wyolum/Celeste/README.md

Celeste
=======

decorative celestial clock

License
-------
[CERN Open Hardware Licence v1.2 ]

[CERN Open Hardware Licence v1.2 ]:http://www.ohwr.org/attachments/2388/cern_ohl_v_1_2.txt
