wyolum/Celeste/fabricate/3D_printed/gears4_8_minute_hand.stl

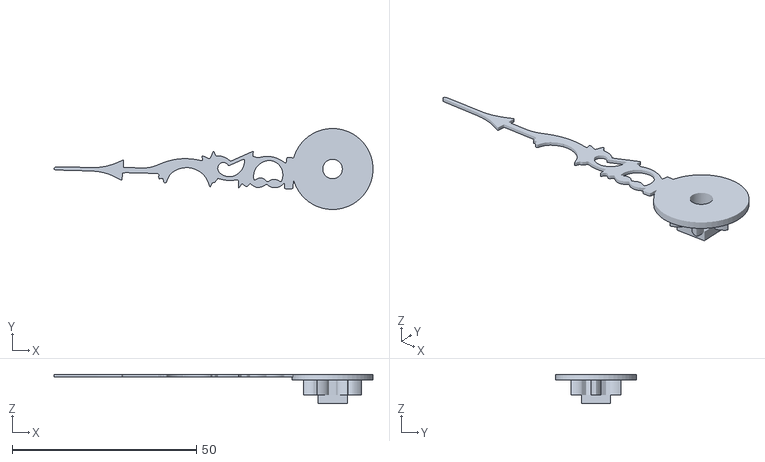
[picture p1: CAD file, 2015-02-06]
fabricate/3D_printed/gears4_8_minute_hand.stl
86.6 x 22.0 x 8.00
