wyolum/Celeste/fabricate/filagreeminute.dxf

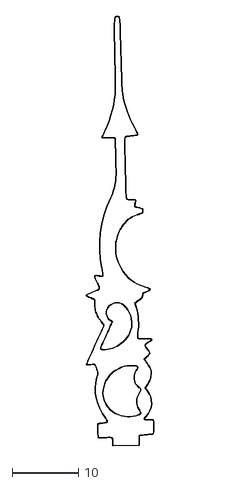
[picture p2: CAD file, 2014-12-28]
fabricate/filagreeminute.dxf
10.2 x 65.0
