wyolum/Celeste/fabricate/3D_printed/gears4_5_hour_hand.stl

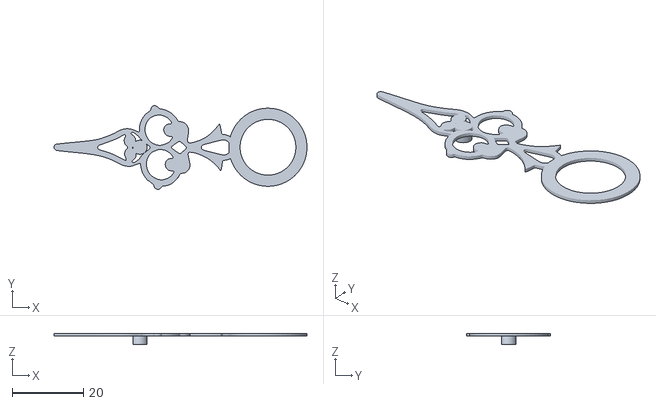
[picture p3: CAD file, 2015-02-06]
fabricate/3D_printed/gears4_5_hour_hand.stl
71.2 x 23.6 x 3.20
