wyolum/Celeste/fabricate/filagreehour.dxf

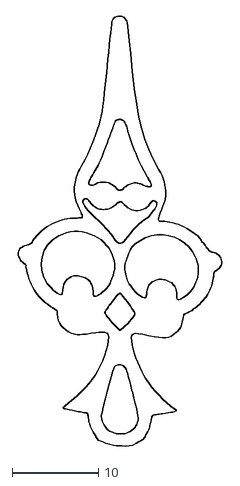
[picture p4: CAD file, 2014-12-28]
fabricate/filagreehour.dxf
23.6 x 49.8
