wyolum/Celeste/fabricate/3D_printed/gears4_7_second_hand.stl

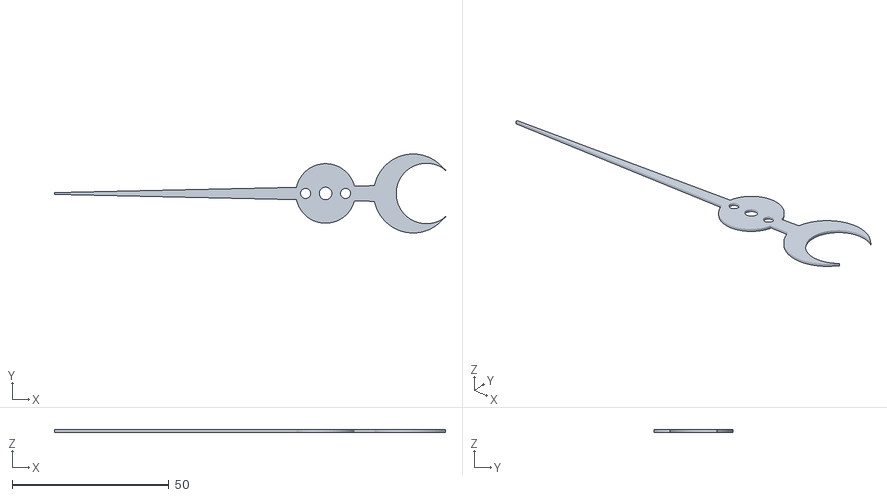
[picture p5: CAD file, 2015-02-06]
fabricate/3D_printed/gears4_7_second_hand.stl
124.6 x 25.2 x 0.8
