wyolum/Celeste/fabricate/minute_hand.stl

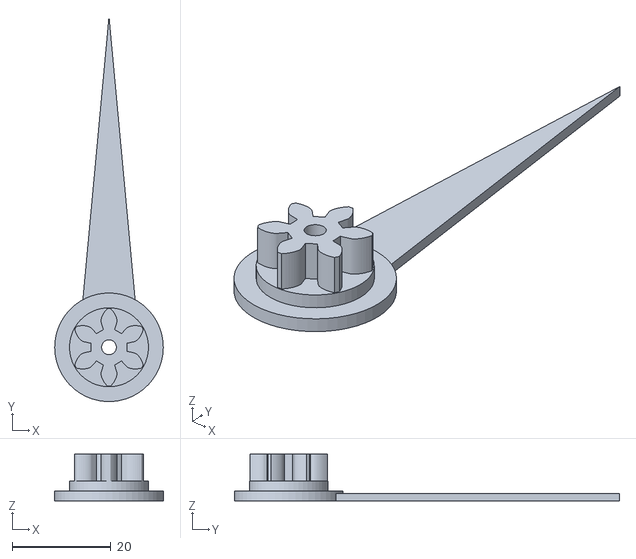
[picture p6: CAD file, 2014-12-27]
fabricate/minute_hand.stl
22.0 x 78.0 x 9.50
