wyolum/Celeste/fabricate/3D_printed/gears4_5_hour_snap.stl

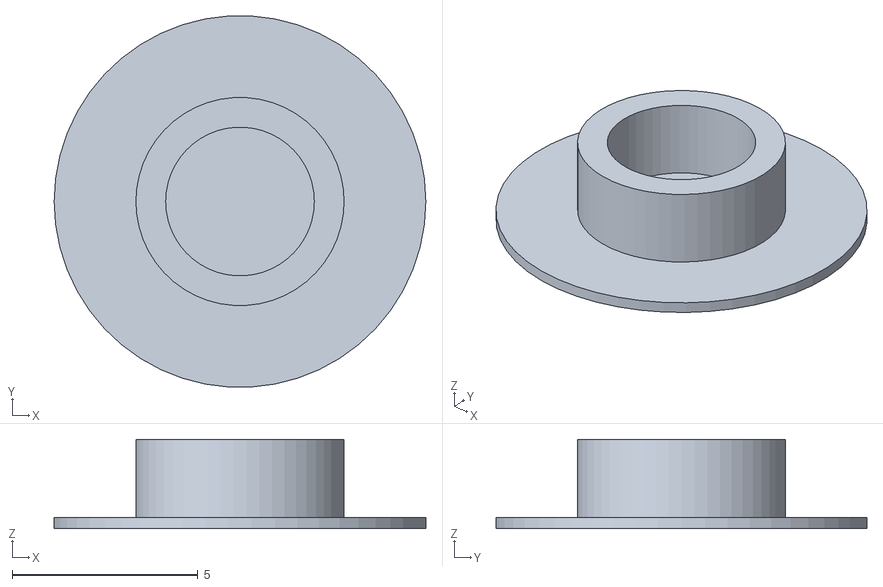
[picture p7: CAD file, 2015-02-06]
fabricate/3D_printed/gears4_5_hour_snap.stl
10.0 x 9.98 x 2.40
