wyolum/Celeste/fabricate/gears.stl

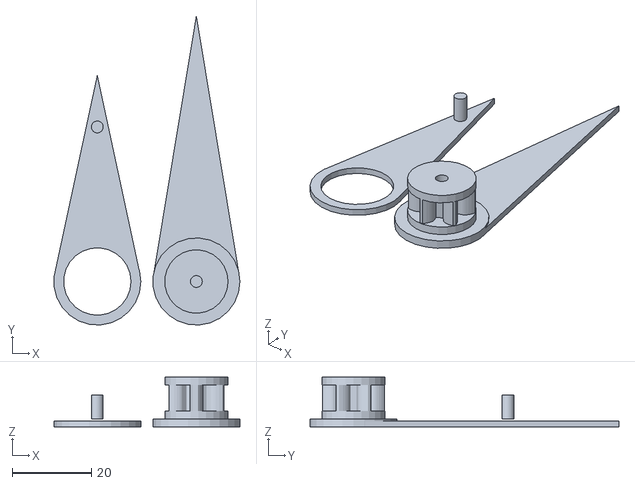
[picture p8: CAD file, 2014-12-18]
fabricate/gears.stl
46.9 x 78.0 x 12.5
