wyolum/Celeste/fabricate/3D_printed/gears4_2_bearing_gear.stl

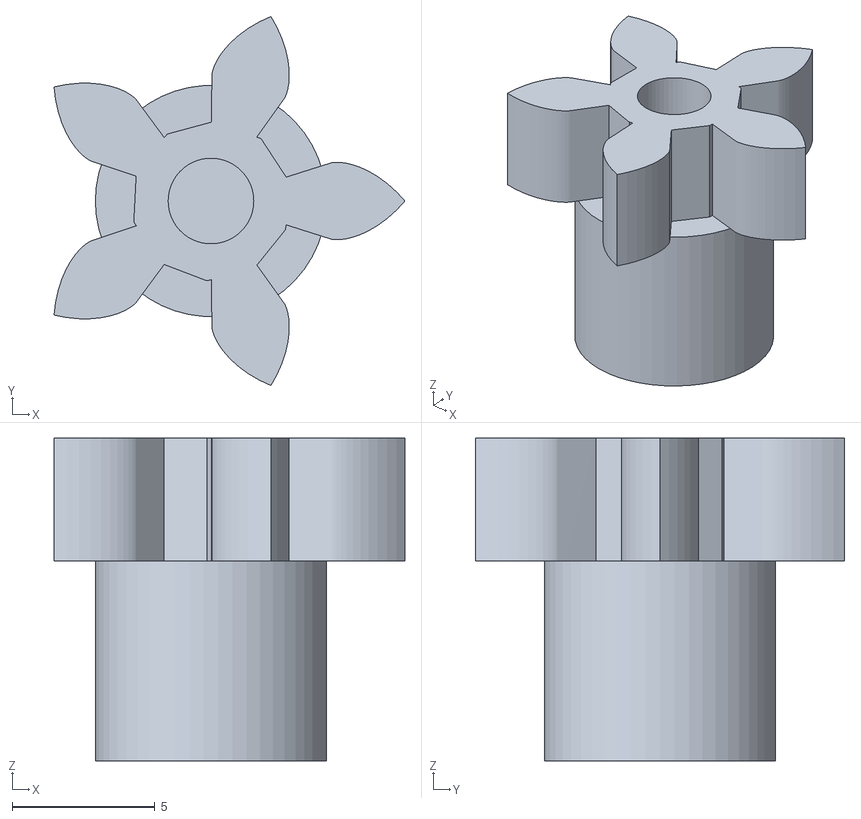
[picture p9: CAD file, 2015-02-06]
fabricate/3D_printed/gears4_2_bearing_gear.stl
12.3 x 12.9 x 11.3
