wyolum/Celeste/fabricate/3D_printed/gears4_1_drive.stl

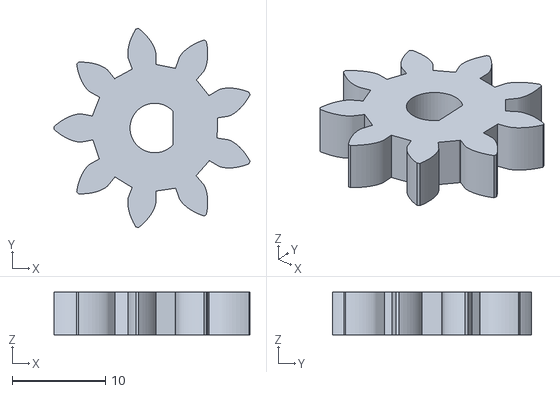
[picture p10: CAD file, 2015-02-03]
fabricate/3D_printed/gears4_1_drive.stl
21.0 x 21.3 x 4.60
