wyolum/Celeste/(list of files, cad)

Other CAD files:
fabricate/Parametric_Involute__Bevel_and_Spur_Gears/parametric_involute_gear_v5.0.scad
fabricate/gears3.scad
fabricate/Parametric_Involute__Bevel_and_Spur_Gears/parametric_involute_gear_v4.0.scad
