wyolum/Celeste/fabricate/images/gear4_image1.png

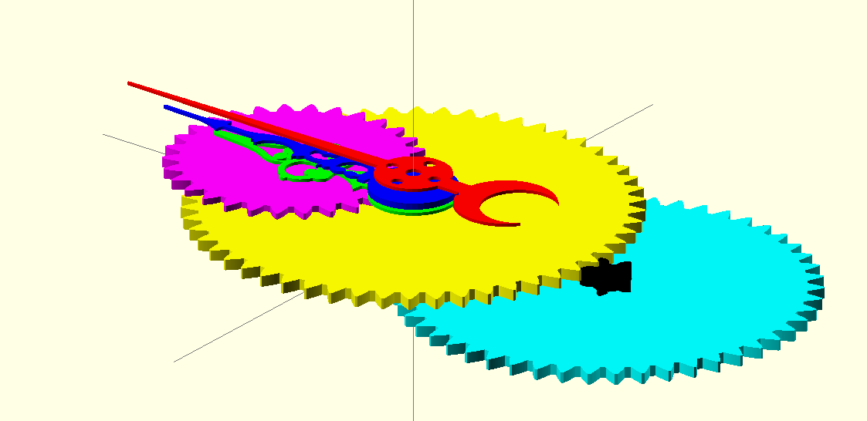
fabricate/images/gear4_image1.png
