wyolum/Celeste/fabricate/images/gear4_image2.png

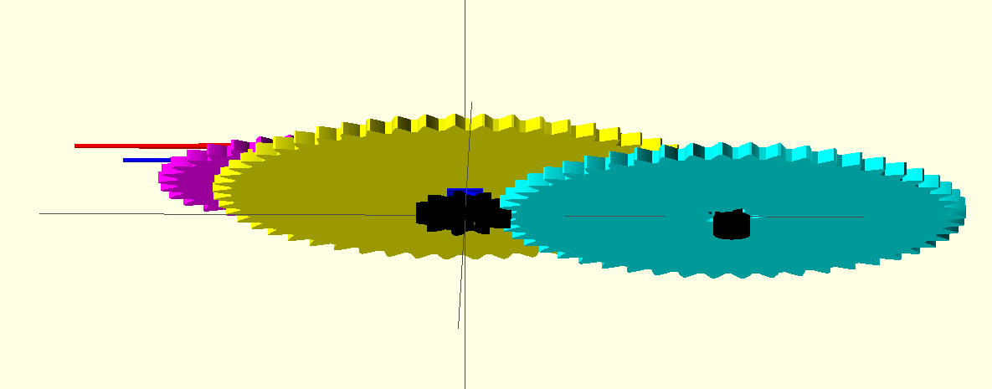
fabricate/images/gear4_image2.png
