wyolum/Celeste/fabricate/images/gear4_image3.png

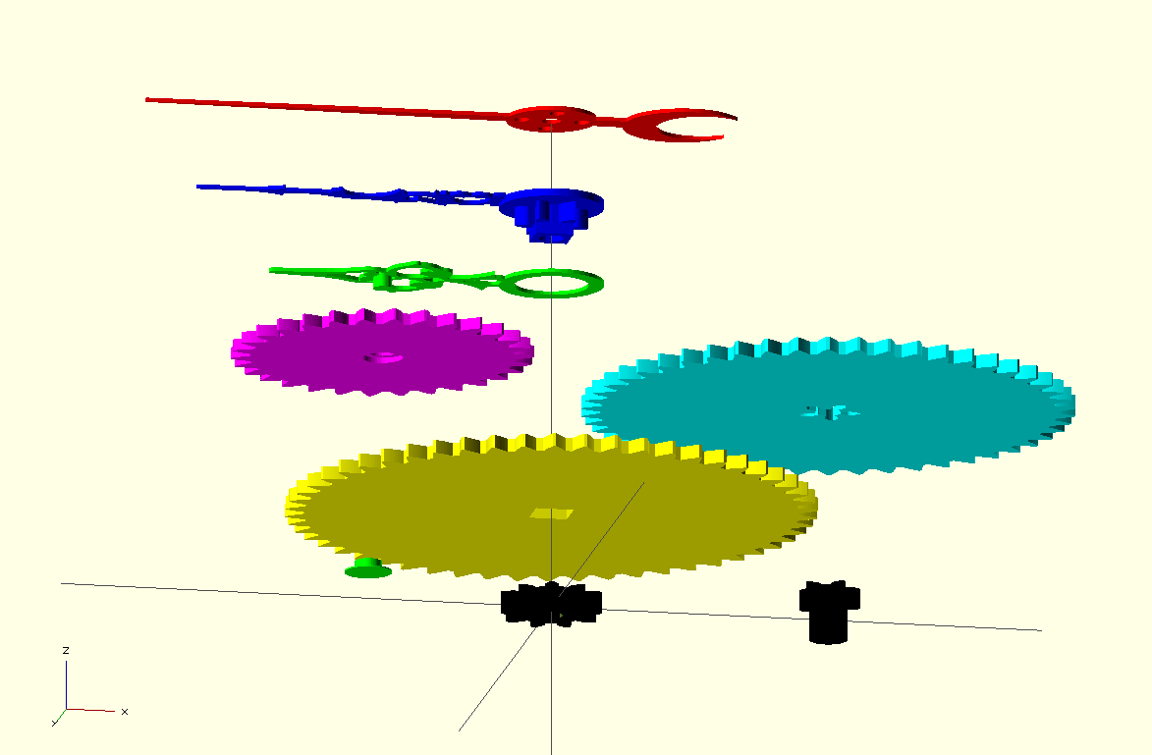
fabricate/images/gear4_image3.png
