wyolum/Celeste/fabricate/images/gear4_image4.png

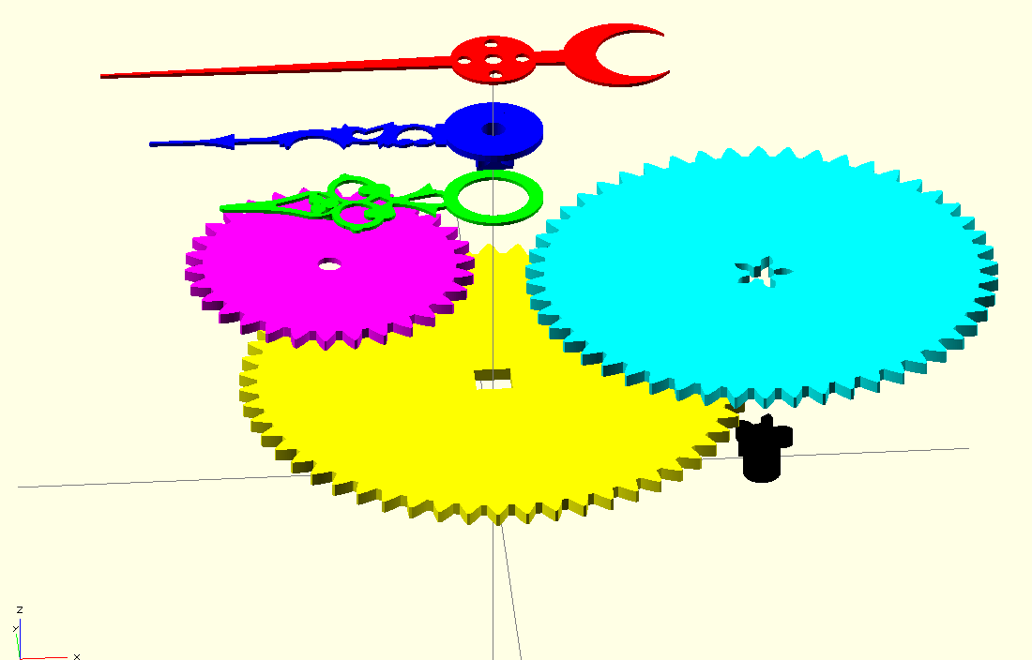
fabricate/images/gear4_image4.png
