wyolum/Celeste/KiCAD/gearclock.pdf

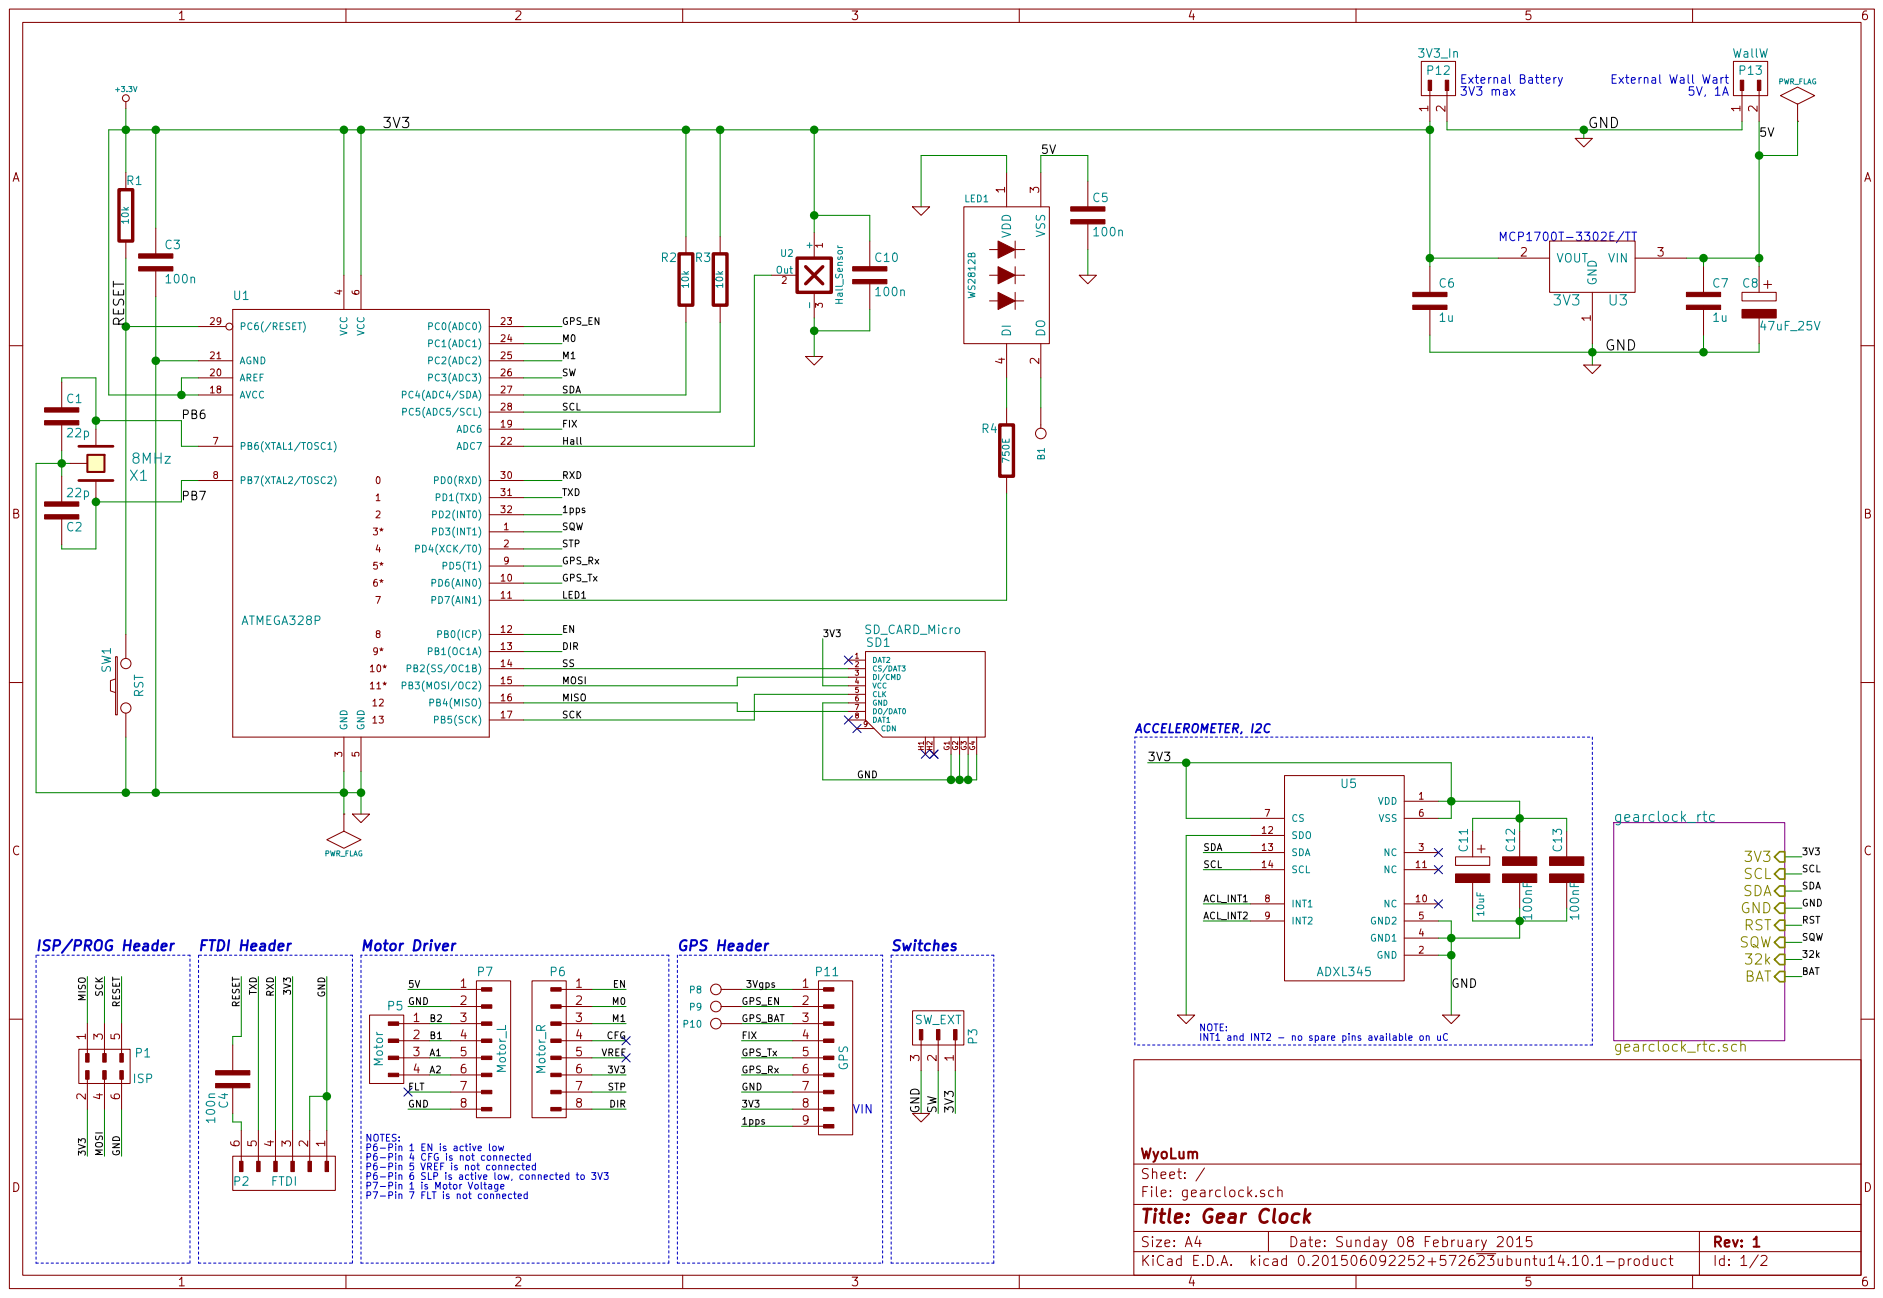
[picture p15: page 1]

6 PB6(XTAL1/TOSC1) 7 PB7(XTAL2/TOSC2) 8 PD5(T1) 9 PD6(AIN0) 10 AREF 20 PD0(RXD) 30 PD7(AIN1) 11 AGND 21 PD1(TXD) 31 PB0(ICP) 12 ADC7 22 PD2(INT0) 32 PB1(OC1A) 13 PC0(ADC0) 23 PB2(SS/OC1B) 14 PC1(ADC1) 24 PB3(MOSI/OC2) 15 PC2(ADC2) 25 PB4(MISO) 16 PC3(ADC3) 26 PB5(SCK) 17 PC4(ADC4/SDA) 27 AVCC 18 PC5(ADC5/SCL) 28 ADC6 19 PC6(/RESET) 29 U1ATMEGA328P

NOTE:
INT1 and INT2 - no spare pins available on uC

NOTES: P6-Pin 1 EN is active low
P6-Pin 4 CFG is not connected P6-Pin 5 VREF is not connected P6-Pin 6 SLP is active low, connected to 3V3 P7-Pin 1 is Motor Voltage P7-Pin 7 FLT is not connected

File: gearclock.sch Sheet: / WyoLum

Id: 1/2 Title: Gear Clock

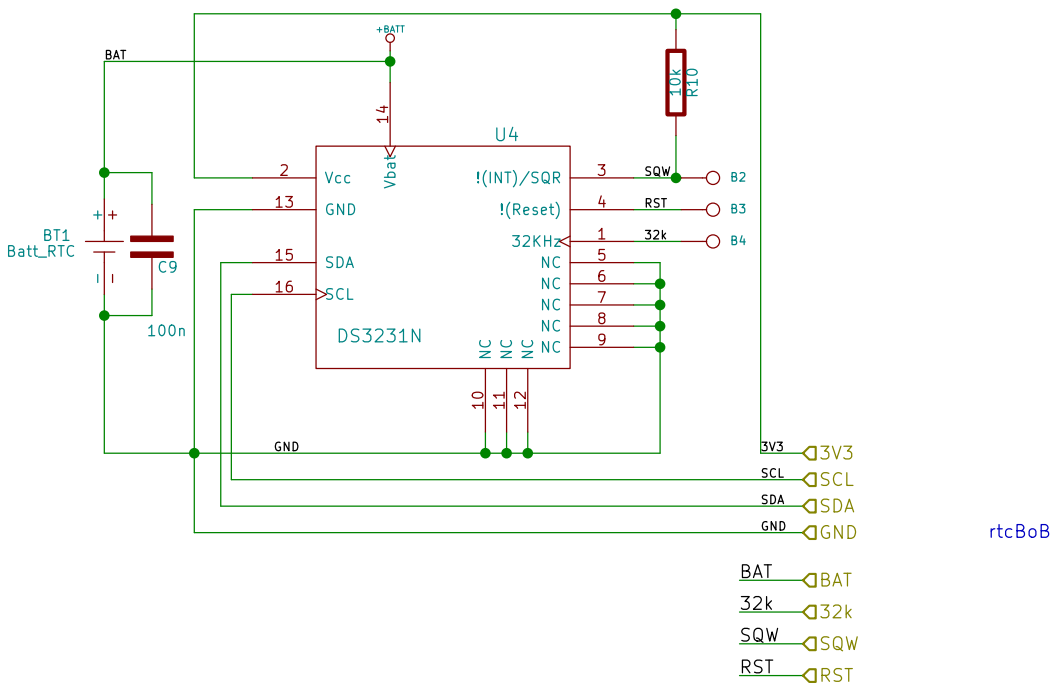
[picture p16: page 2]

WyoLum
Sheet: /gearclock_rtc/
File: gearclock_rtc.sch
Id: 2/2 Title: Gear Clock
