wyolum/Celeste/KiCAD/gearclock.kicad_pcb

## KiCad design KiCAD/gearclock.kicad_pcb (2015-06-12)

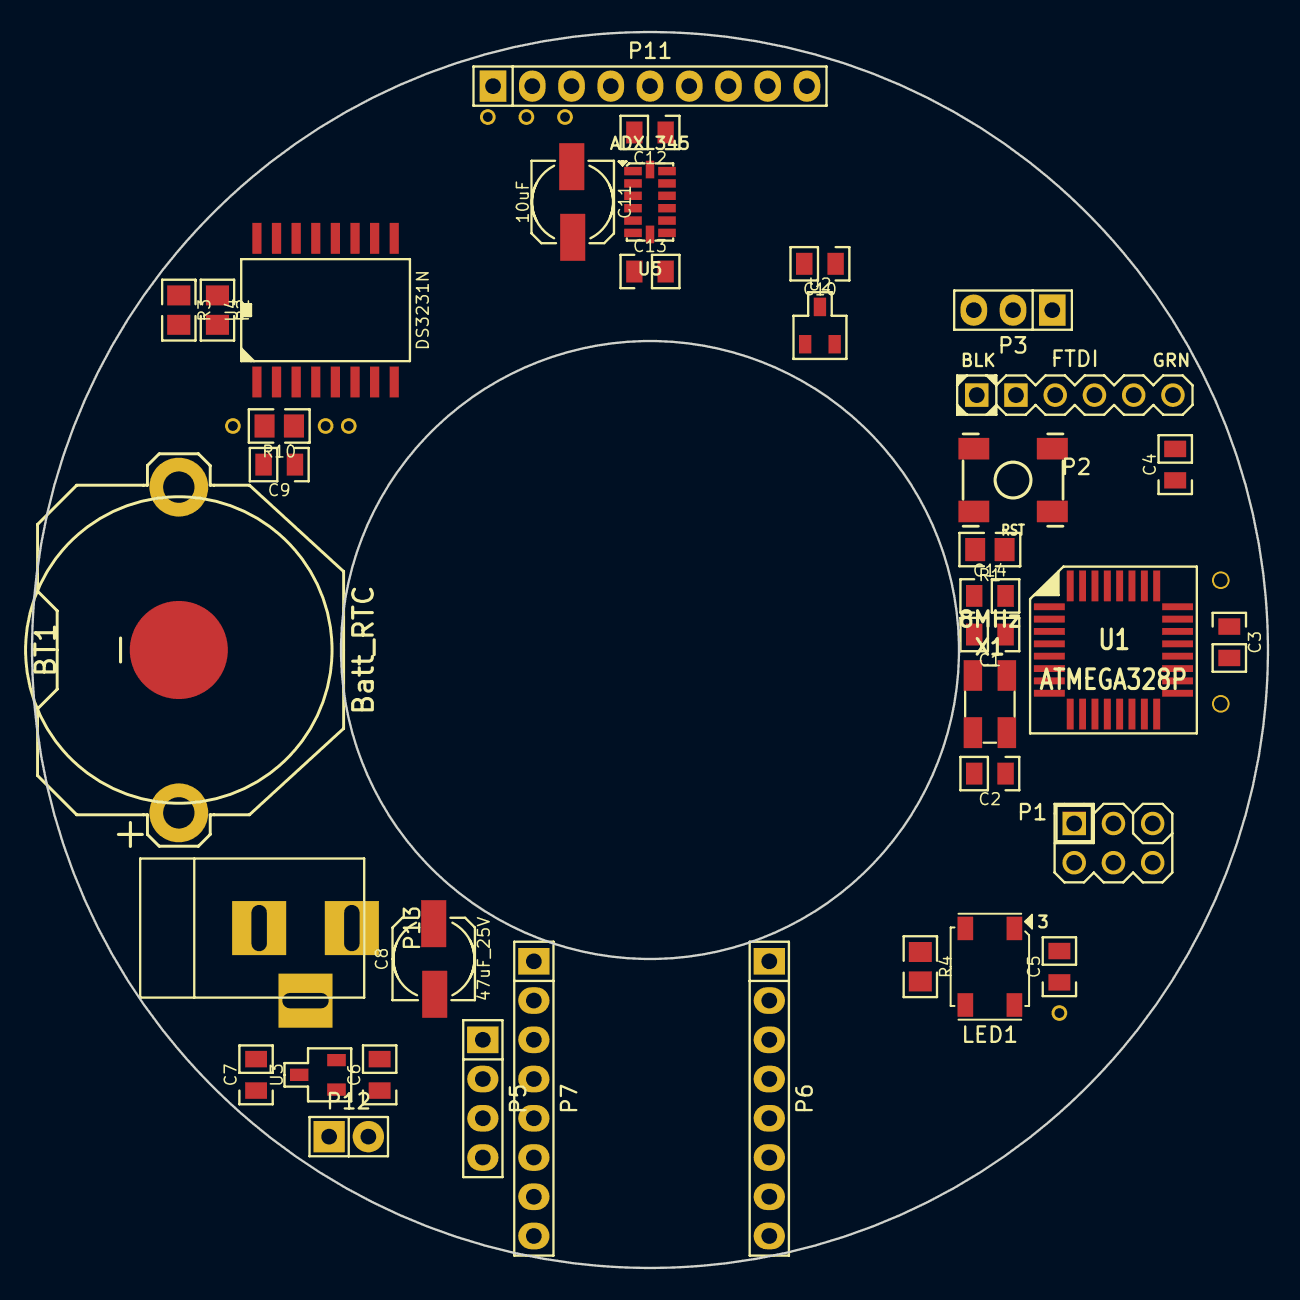
[picture p17: board gearclock.kicad_pcb from above]

Board: 2 copper layers, 80.0 x 80.0 mm, 45 parts (1 on the bottom side), 40 nets, no tracks yet.

Parts:
B1, B2, B3, B4: IO
BT1: Batt_RTC; CR2032
C1, C2: 22p; c_0805
C3, C4, C5, C9, C10, C14: 100n; c_0805
C6, C7: 1u; c_0805
C8: 47uF_25V; C_ELCO_SMD
C11: 10uF; C_ELCO_SMD
C12, C13: 100nF; c_0805
LED1: WS2812B; RGB_WS2811B
P1: ISP; Header_ISP
P2: FTDI; Header_FTDI
P3: SW_EXT; Pin_Header_Straight_1x03
P5: Motor; Pin_Header_Straight_1x04
P6: Motor_R; Pin_Header_Straight_1x08
P7: Motor_L; Pin_Header_Straight_1x08
P8, P9, P10: IO
P11: GPS; Pin_Header_Straight_1x09
P12: 3V3_In; Pin_Header_Straight_1x02
P13: WallW; BARREL_JACK
R1, R2, R3, R10: 10k; r_0805
R4: 750E; r_0805
SD1: SD_CARD_Micro; SD_Micro
SW1: RST; Switch_SMT
U1: ATMEGA328P; TQFP32
U2: Hall_Sensor; SOT23-3
U3: 3V3; SOT23-3
U4: DS3231N; DS3231
U5: ADXL345
X1: 8MHz; Xtal_SMD4

Connections:
+3.3V: C3.1, C6.1, C10.1, C11.1, C12.1, C13.1, C14.1, P1.2, P2.3, P3.1, P6.6, P11.8, P12.1, R1.1, R2.1, R3.1, R10.1, SD1.4, U1.4, U1.6, U1.18, U1.20, U2.1, U3.2, U4.2, U5.1, U5.6, U5.7
/1pps: P11.9, U1.32
/3Vgps: P8.1, P11.1
/5V: C5.1, C7.1, C8.1, LED1.3, P7.1, P13.2, U3.3
/A1: P5.3, P7.5
/A2: P5.4, P7.6
/B1: P5.2, P7.4
/B2: P5.1, P7.3
/DIR: P6.8, U1.13
/EN: P6.1, U1.12
/FIX: P11.4, U1.19
/GPS_BAT: P10.1, P11.3
/GPS_EN: P9.1, P11.2, U1.23
/GPS_Rx: P11.6, U1.9
/GPS_Tx: P11.5, U1.10
/Hall: U1.22, U2.2
/LED1: R4.2, U1.11
/M0: P6.2, U1.24
/M1: P6.3, U1.25
/MISO: P1.1, SD1.7, U1.16
/MOSI: P1.4, SD1.3, U1.15
/PB6: C1.1, U1.7, X1.1
/PB7: C2.2, U1.8, X1.2
/RESET: C4.2, P1.5, R1.2, SW1.2, U1.29
/RXD: P2.4, U1.30
/SCK: P1.3, SD1.5, U1.17
/SS: SD1.2, U1.14
/STP: P6.7, U1.2
/SW: P3.2, U1.26
/TXD: P2.5, U1.31
/gearclock_rtc/32k: B4.1, U4.1
/gearclock_rtc/BAT: BT1.+, C9.1, U4.14
/gearclock_rtc/RST: B3.1, U4.4
/gearclock_rtc/SCL: R3.2, U1.28, U4.16, U5.14
/gearclock_rtc/SDA: R2.2, U1.27, U4.15, U5.13
/gearclock_rtc/SQW: B2.1, R10.2, U1.1, U4.3
GND: BT1.-, C1.2, C2.1, C3.2, C5.2, C6.2, C7.2, C8.2, C9.2, C10.2, C11.2, C12.2, C13.2, C14.2, LED1.1, P1.6, P2.1, P2.2, P3.3, P7.2, P7.8, P11.7, P12.2, P13.1, SD1.6, SD1.G1, SD1.G2, SD1.G3, SD1.G4, SW1.1, U1.3, U1.5, U1.21, U2.3, U3.1, U4.5, U4.6, U4.7, U4.8, U4.9, U4.10, U4.11, U4.12, U4.13, U5.2, U5.4, U5.5, U5.12, X1.3
unnamed: B1.1, LED1.2
unnamed: C4.1, P2.6
unnamed: LED1.4, R4.1
