wyolum/Celeste/(commit log)

2014-02-17 cleaned stl files and emacs files
    [backlash_option_demo.stl, bevel_gear_pair.stl, celeste_gear_test_24.stl, celeste_gear_test_24x200.stl, celeste_gear_test_24x50.stl, celeste_gear_test_6.stl, celeste_gear_test_9x80.stl, complex_spur_gear_test.stl]
2014-02-17 broke out 6 tooth gear into seperate file from gear library
    [parametric_involute_gear_v5.0.scad]
2014-02-17 added gear.scad as a seperate file from gear library
    [gears.scad]
2014-02-23 added moon.scad
    [gears.scad, moon.scad]
2014-03-23 added minute hand to gear
    [gears.scad, minute_hand.stl, moon.scad]
2014-03-23 added gear_clock to repo
2014-04-05 aded svg files for gear_clock2
2014-04-05 added arduino code
2014-11-29 added hour hand
    [gears.scad, gears.stl]
2014-11-29 minor adjustment
    [gears.scad, gears.stl]
2014-11-29 added acrylic pieces
    [gears.scad]
2014-12-18 modified inner gear, added holes
    [gears.scad, gears.stl, minute_hand.stl]
2014-12-19 added required libs
    [gears.scad, minute_hand.stl]
2014-12-20 added .25 inch laser cutting layer
    [gears.scad]
2014-12-20 modified for laser cutting
2014-12-20 added sheet to gear clock for lasering
2014-12-22 tweaked inner_gear to spin better
    [gears.scad]
2014-12-24 bored all the way though minute hand so that it can be pressed furhter in
    [gears.scad, minute_hand.stl]
2014-12-27 made hands thinner
    [gears.scad, minute_hand.stl]
2014-12-28 add filagree hands
    [filagreehour.dxf, filagreeminute.dxf, gears.scad]
2014-12-28 lengthed hour hand pin to accomodate new inner_gear
    [gears.scad]
2014-12-29 made inner gear a bit thicker to reduce rattling
    [gears.scad]
2014-12-29 now catches after power outage.
    [gears.scad]
2015-01-19 added new version of GearClock Gears3
    [gears.scad]
2015-01-21 added gears 3 clock
    [gears3.scad]
2015-01-21 schematic file
2015-01-29 added gearclock4 h:m:s clock
    [gears4.scad, gears4_1_drive.stl, gears4_2_59_5.stl, gears4_3_54_6.stl, gears4_4_planet.stl, gears4_5_hour.stl, gears4_6_ring.stl, gears4_7_second.stl]
2015-01-29 more gear clock stuff
2015-01-30 first working version of GearClock4
    [gears4.scad, gears4_3_54_6.stl, gears4_5_hour.stl, gears4_8_minute.stl]
2015-02-02 made all large gears out of acrylic. working version
    [gears4.scad, gears4_5_hour.stl]
2015-02-03 added laser cut parts to scad
    [gears4.scad, gears4_1_drive.stl]
2015-02-04 minor changes to stack
    [gears4.scad]
2015-02-06 clean up for kevins print
    [gears4.scad, gears4_1_drive.stl, gears4_2_59_5.stl, gears4_2_bearing_gear.stl, gears4_3_54_6.stl, gears4_4_planet.stl, gears4_5_hour.stl, gears4_5_hour_hand.stl]
2015-02-08 changed filenames of images
    [gears4.scad, gears4_3_54_6.stl, gears4_7_second.stl]
2015-02-08 made bearing cutout 22.1mm
2015-02-08 Gear Clock schematic work in progress
    [gearclock.sch, gearclock_rtc.sch]
2015-02-13 converting to 2x gear pitch
    [gears4.scad]
2015-02-15 added NOTES.txt for pcb
    [gears4.scad]
2015-02-22 GearClock schematic needs review
    [gearclock.sch, gearclock_rtc.sch]
2015-02-23 GearClock schematic mods
    [gearclock.sch]
2015-02-25 GearClock schematic update
    [gearclock.sch, gearclock_rtc.sch]
2015-02-28 GearClock schematic work in progress
2015-06-09 review the schematic
    [gearclock.sch]
2015-06-11 Schematic, work in progress
    [gearclock.sch, gearclock_rtc.sch]
